em-robot/plenbit-AtomBoard/Schematic/AtomBoard.pdf

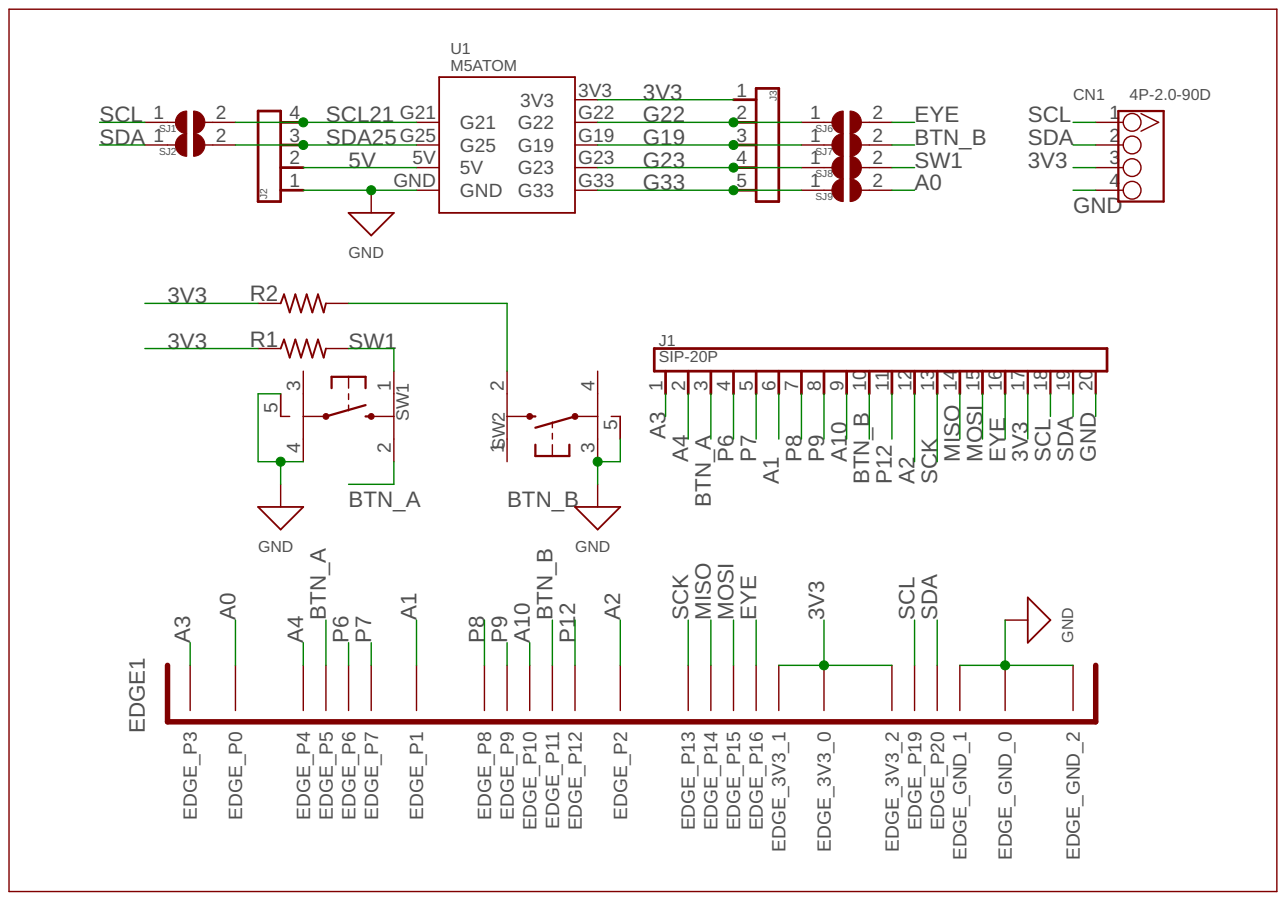
[picture p3: page 1]
